gnetscher/RBG-Bike-POV/Spoke Ink/Poster.JPG

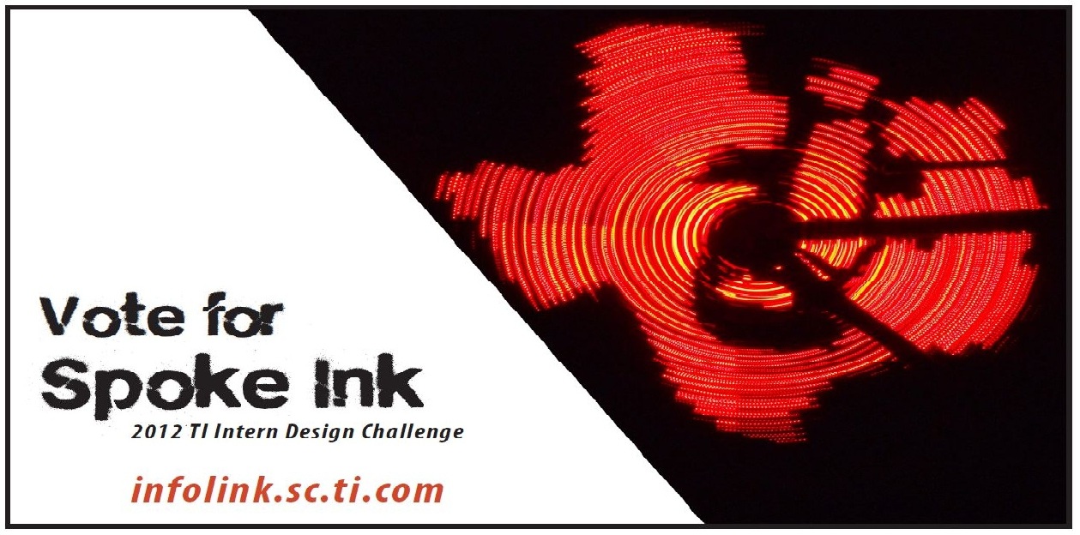
Spoke Ink/Poster.JPG
