gnetscher/RBG-Bike-POV/1st place.JPG

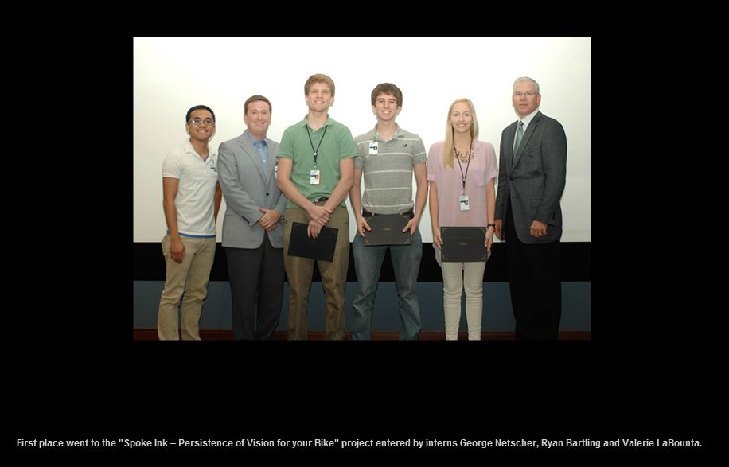
1st place.JPG
