gnetscher/RBG-Bike-POV/README.md

RBG-Bike-POV
============

Created for the TI Intern Design Contest 2012
