gnetscher/RBG-Bike-POV/Spoke Ink/Spoke_Ink_Mini_Flyer_2up_v4_bw1.pdf

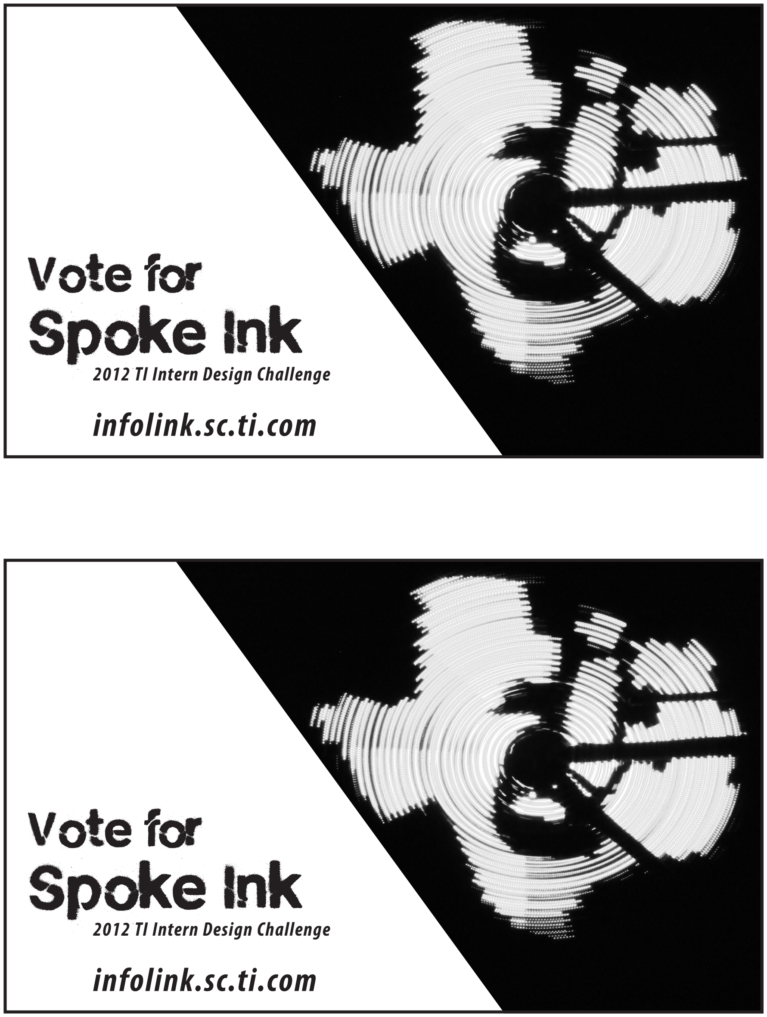
[picture p3: page 1]

Vote for Spoke Ink 2012 TI Intern Design Challenge

# infolink.sc.ti.com

Vote for Spoke Ink 2012 TI Intern Design Challenge

# infolink.sc.ti.com
