gnetscher/RBG-Bike-POV/Spoke Ink/Bike Pictures/142.JPG

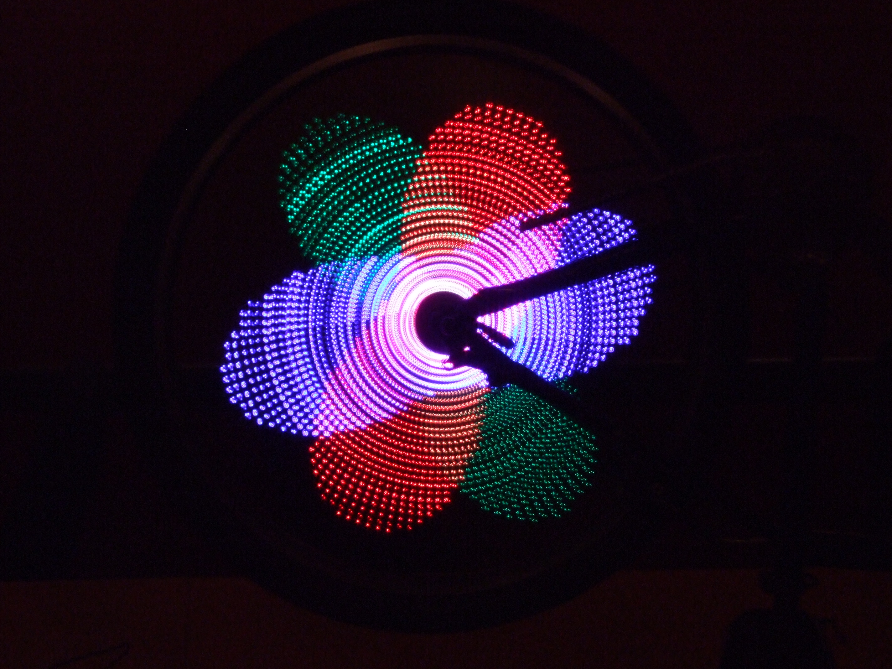
Spoke Ink/Bike Pictures/142.JPG
