gnetscher/RBG-Bike-POV/Spoke Ink/Bike Pictures/149.JPG

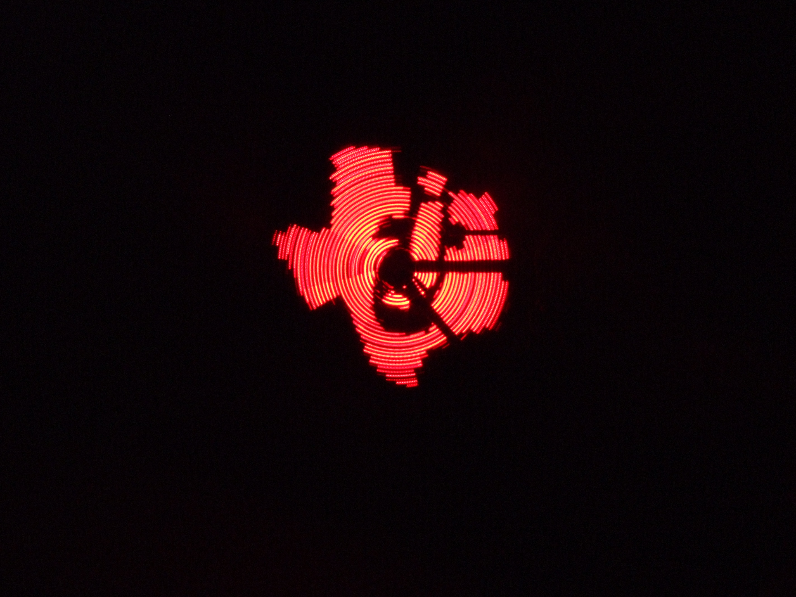
Spoke Ink/Bike Pictures/149.JPG
