gnetscher/RBG-Bike-POV/Spoke Ink/Bike Pictures/162.JPG

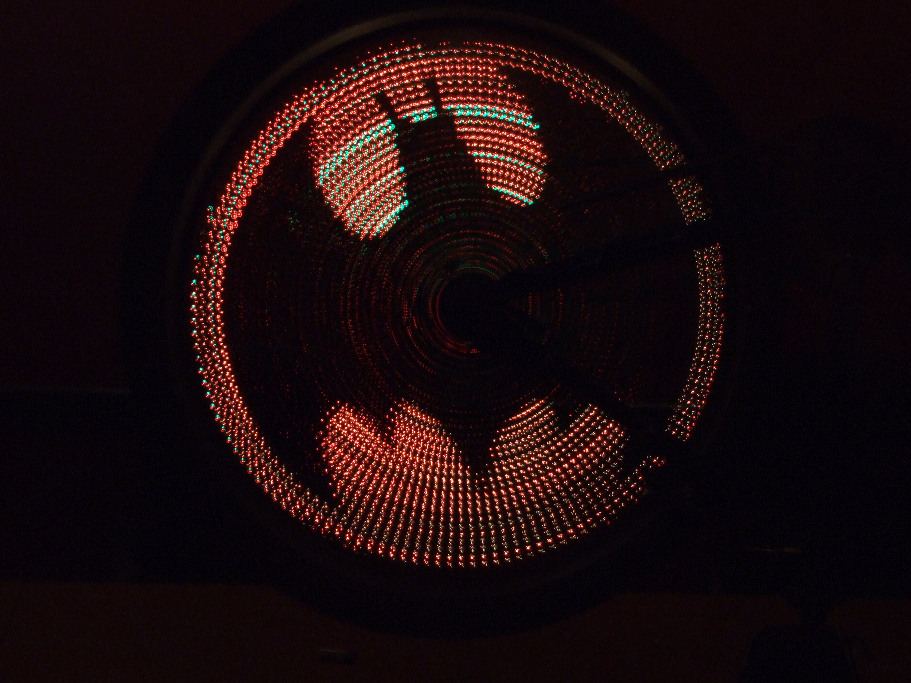
Spoke Ink/Bike Pictures/162.JPG
