gnetscher/RBG-Bike-POV/Spoke Ink/Bike Pictures/348.JPG

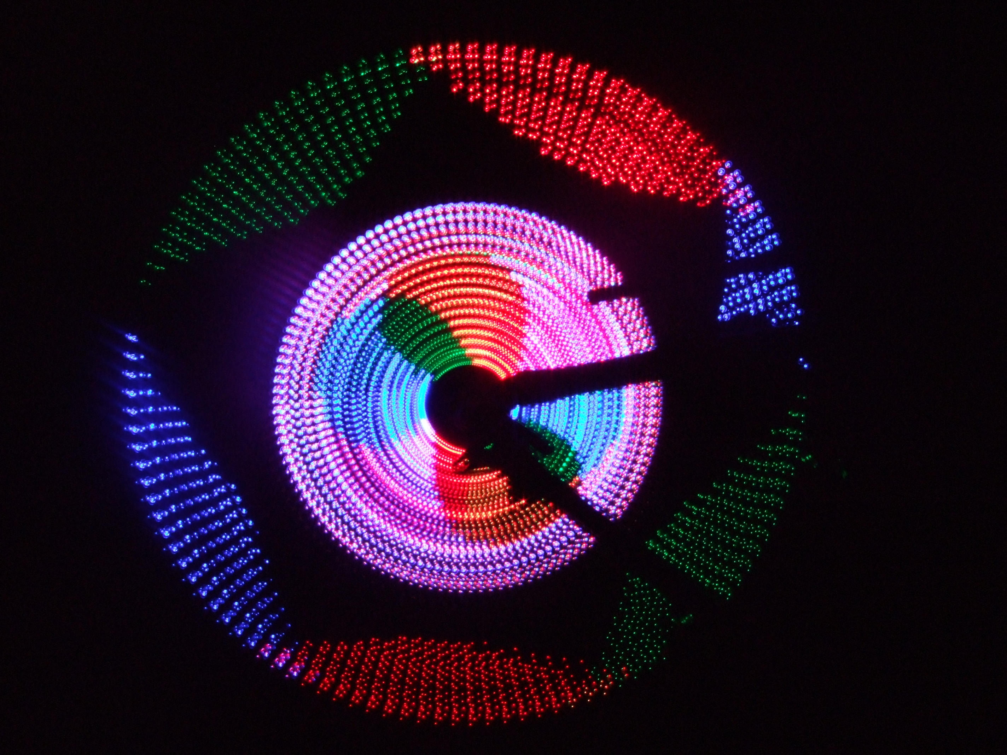
Spoke Ink/Bike Pictures/348.JPG
