gnetscher/RBG-Bike-POV/Spoke Ink/Bike Pictures/DSCF1652.JPG

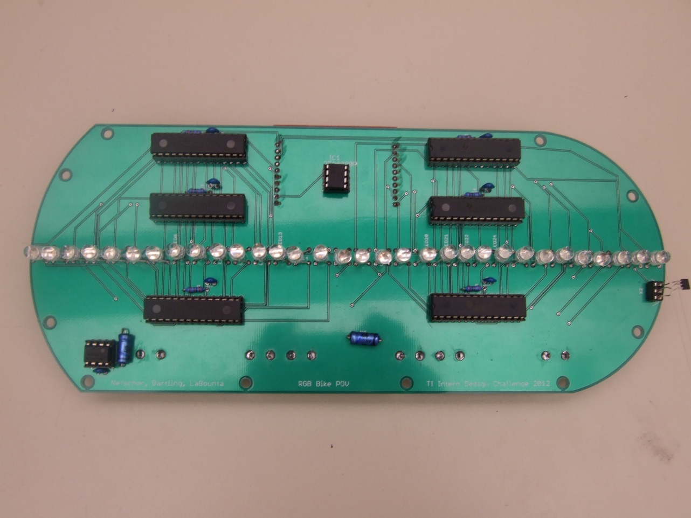
Spoke Ink/Bike Pictures/DSCF1652.JPG
