gnetscher/RBG-Bike-POV/Spoke Ink/Bike Pictures/DSCF1653.JPG

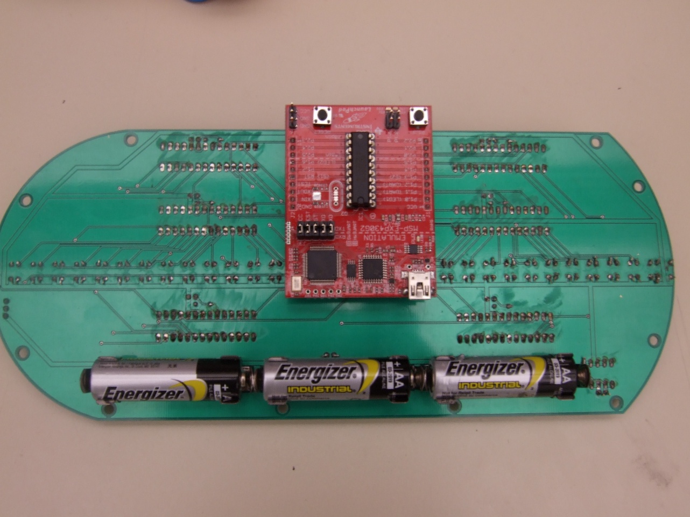
Spoke Ink/Bike Pictures/DSCF1653.JPG
