gnetscher/RBG-Bike-POV/Spoke Ink/Bike Pictures/Team.jpg

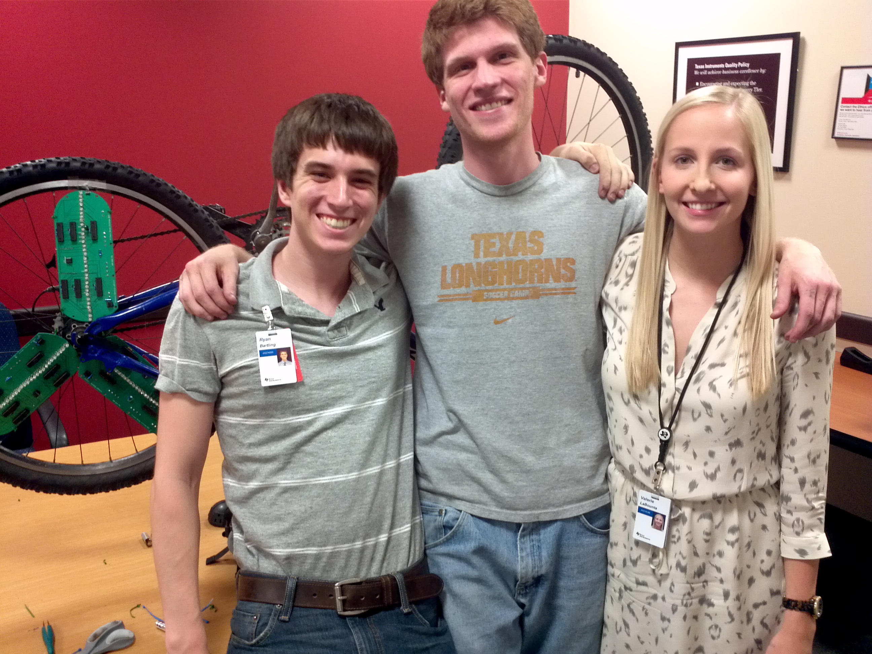
Spoke Ink/Bike Pictures/Team.jpg
