gnetscher/RBG-Bike-POV/Spoke Ink/Spoke Ink/Bill of Materials.docx

Spoke Ink – Bill of Materials

Part | Quantity | Price
Custom PCB | 3 | $260.68
Common Anode RGB LED | 96 | $57.70
US 5881 (Hall Effect Sensor) | 3 | $3.24
TLC5940 (LED driver) | 18 | $39.78
TPS7333 (Voltage Regulator) | 3 | $3.08
Battery Clips | 9 | $1.71

Total: $366.19

As compared to those offered commercially for $2000!

http://www.monkeylectric.com/video_pro_wheel_screen/
