gnetscher/RBG-Bike-POV/Spoke Ink/Spoke Ink/RGB_Bike_POV_v3.brd

## EAGLE design Spoke Ink/Spoke Ink/RGB_Bike_POV_v3.brd (2012-08-11)

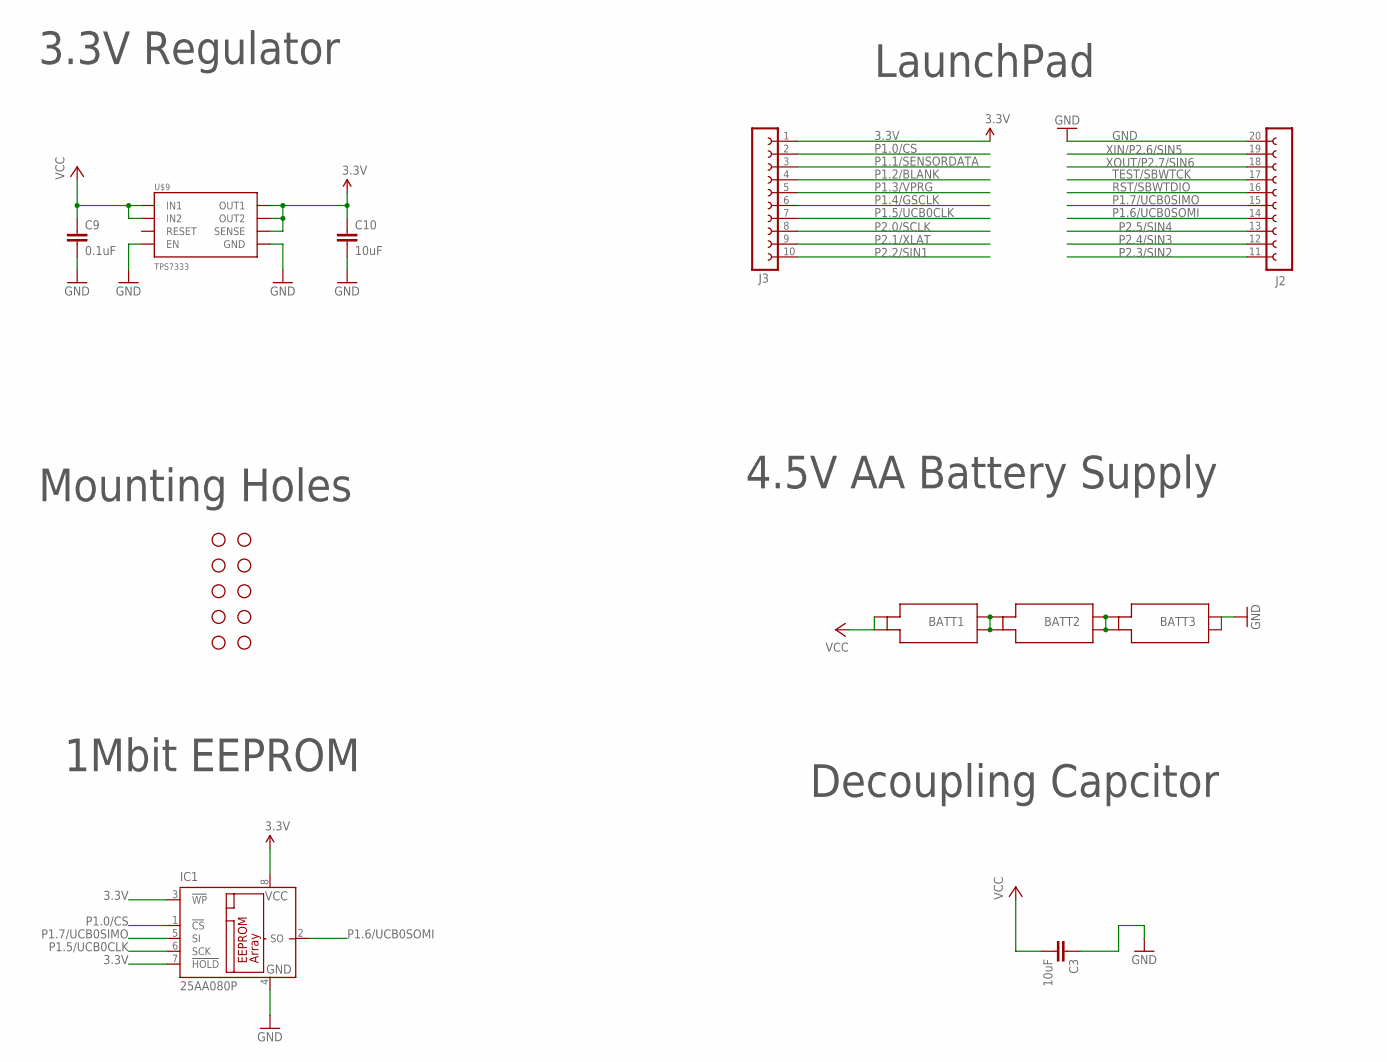
[picture p11: schematic RGB_Bike_POV_v3.sch, sheet 1]

Parts:
BATT1, BATT2, BATT3: 1XAA
C3, C10: 10uF; CAP-PTH-SMALL
C9: 0.1uF; CAP-PTH-SMALL
IC1: 25AA080P; DIL8
J2: FE10H
J3: FE10L; FE10
JP1, JP2, JP3, JP4, JP5, JP7, JP25, JP26, JP27, JP28: STAND-OFF
U$9: TPS7333

Connections:
3.3V: C10.1, IC1.3 (!WP), IC1.7 (!HOLD), IC1.8 (VCC), J3.1, U$9.5 (OUT1), U$9.6 (OUT2), U$9.7 (SENSE); also elsewhere on the board
GND: BATT3.N1, BATT3.N2, C3.1, C9.2, C10.2, IC1.4 (GND), J2.20 (10), U$9.1 (GND), U$9.2 (EN); also elsewhere on the board
unnamed: BATT1.N1, BATT1.N2, BATT2.P1, BATT2.P2
unnamed: BATT2.N1, BATT2.N2, BATT3.P1, BATT3.P2
P1.0/CS: IC1.1 (!CS), J3.2
P1.1/SENSORDATA: J3.3; also elsewhere on the board
P1.2/BLANK: J3.4; also elsewhere on the board
P1.3/VPRG: J3.5; also elsewhere on the board
P1.4/GSCLK: J3.6; also elsewhere on the board
P1.5/UCB0CLK: IC1.6 (SCK), J3.7
P1.6/UCB0SOMI: IC1.2 (SO), J2.14 (4)
P1.7/UCB0SIMO: IC1.5 (SI), J2.15 (5)
P2.0/SCLK: J3.8; also elsewhere on the board
P2.1/XLAT: J3.9; also elsewhere on the board
P2.2/SIN1: J3.10; also elsewhere on the board
P2.3/SIN2: J2.11 (1); also elsewhere on the board
P2.4/SIN3: J2.12 (2); also elsewhere on the board
P2.5/SIN4: J2.13 (3); also elsewhere on the board
RST/SBWTDIO: J2.16 (6)
TEST/SBWTCK: J2.17 (7)
VCC: BATT1.P1, BATT1.P2, C3.2, C9.1, U$9.3 (IN1), U$9.4 (IN2); also elsewhere on the board
XIN/P2.6/SIN5: J2.19 (9); also elsewhere on the board
XOUT/P2.7/SIN6: J2.18 (8); also elsewhere on the board

Notes on the sheet:
Mounting Holes
3.3V Regulator
LaunchPad
4.5V AA Battery Supply
1Mbit EEPROM
Decoupling Capcitor

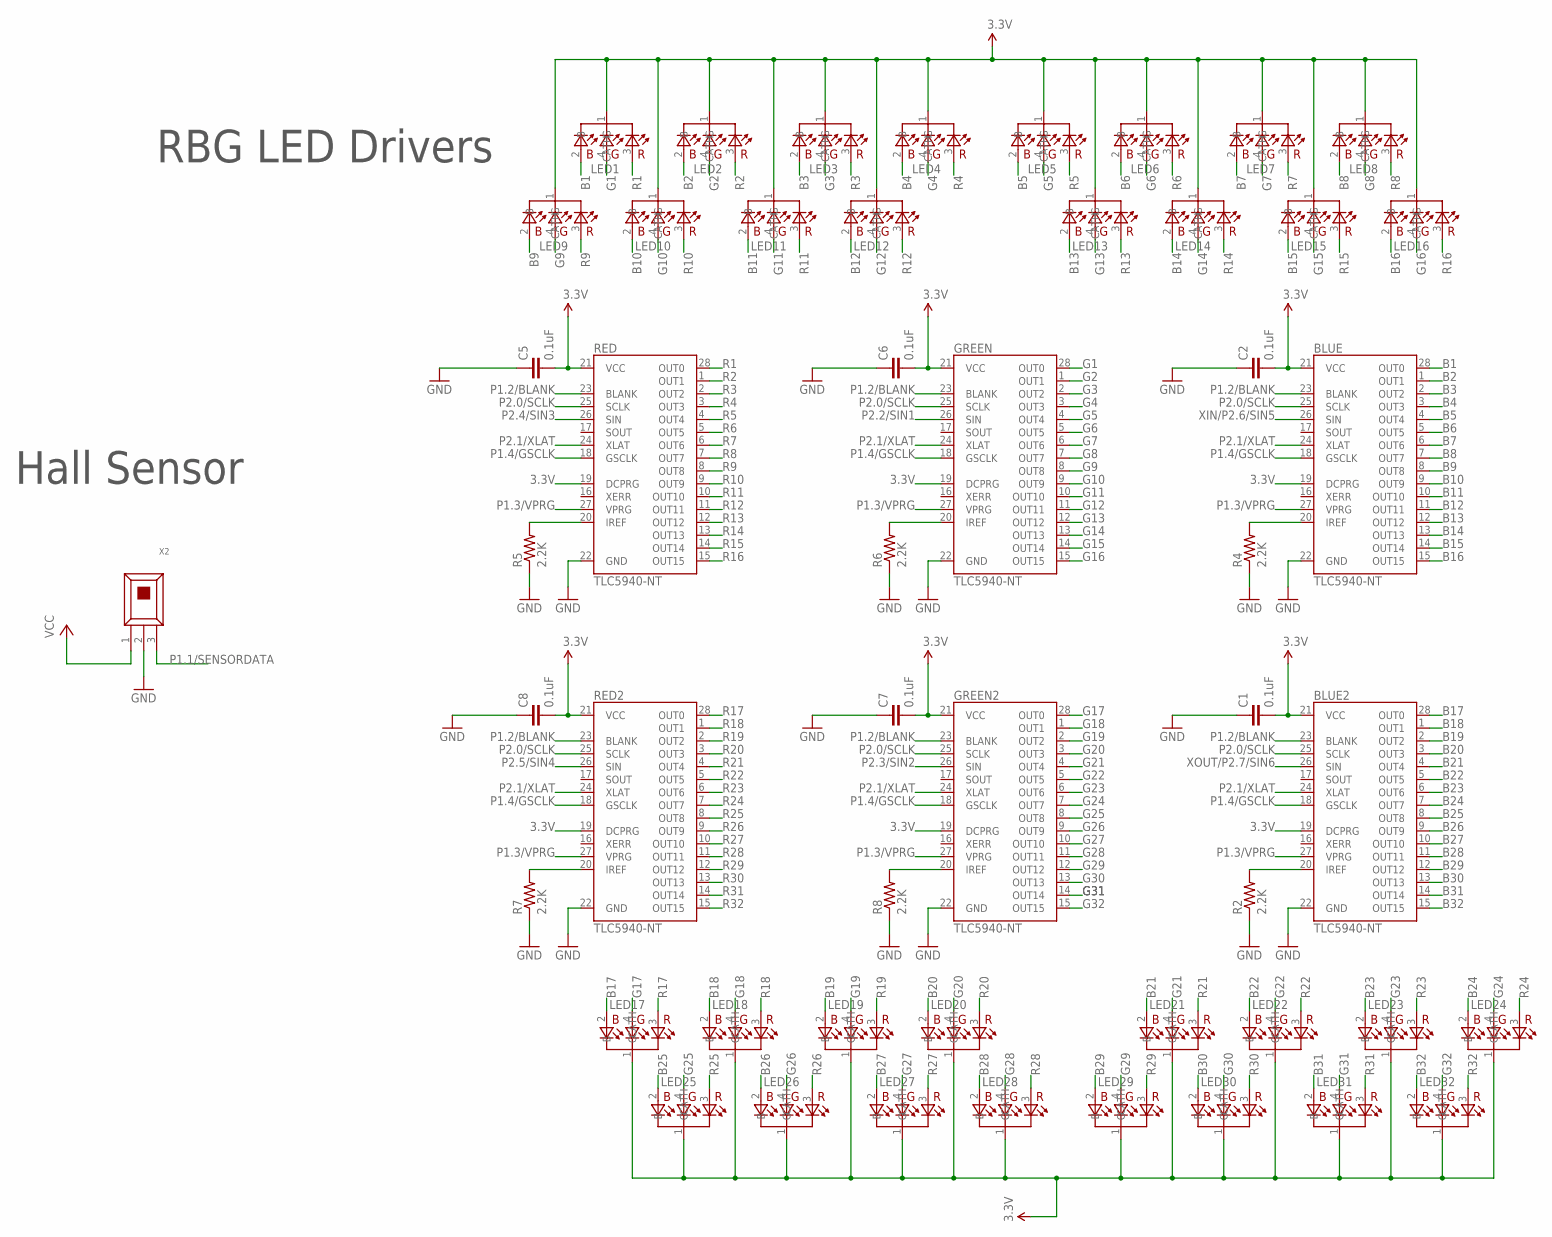
[picture p12: schematic RGB_Bike_POV_v3.sch, sheet 2]

Parts:
BLUE, BLUE2: TLC5940-NT; DIL28-3
C1, C2, C5, C6, C7, C8: 0.1uF; CAP-PTH-SMALL
GREEN, GREEN2: TLC5940-NT; DIL28-3
LED1, LED2, LED3, LED4, LED5, LED6, LED7, LED8, LED9, LED10, LED11, LED12, LED13, LED14, LED15, LED16, LED17, LED18, LED19, LED20, LED21, LED22, LED23, LED24, LED25, LED26, LED27, LED28, LED29, LED30, LED31, LED32: LED_SUPERFLUX_RGB_CATH; LED_SUPERFLUX
R2, R4, R5, R6, R7, R8: 2.2K; 1/6W-RES
RED, RED2: TLC5940-NT; DIL28-3
X2: HALLEFFECT; 3SIP

Connections:
3.3V: BLUE.19 (DCPRG), BLUE.21 (VCC), BLUE2.19 (DCPRG), BLUE2.21 (VCC), C1.2, C2.2, C5.2, C6.2, C7.2, C8.2, GREEN.19 (DCPRG), GREEN.21 (VCC), GREEN2.19 (DCPRG), GREEN2.21 (VCC), LED1.1 (CATH), LED2.1 (CATH), LED3.1 (CATH), LED4.1 (CATH), LED5.1 (CATH), LED6.1 (CATH), LED7.1 (CATH), LED8.1 (CATH), LED9.1 (CATH), LED10.1 (CATH), LED11.1 (CATH), LED12.1 (CATH), LED13.1 (CATH), LED14.1 (CATH), LED15.1 (CATH), LED16.1 (CATH), LED17.1 (CATH), LED18.1 (CATH), LED19.1 (CATH), LED20.1 (CATH), LED21.1 (CATH), LED22.1 (CATH), LED23.1 (CATH), LED24.1 (CATH), LED25.1 (CATH), LED26.1 (CATH), LED27.1 (CATH), LED28.1 (CATH), LED29.1 (CATH), LED30.1 (CATH), LED31.1 (CATH), LED32.1 (CATH), RED.19 (DCPRG), RED.21 (VCC), RED2.19 (DCPRG), RED2.21 (VCC); also elsewhere on the board
B1: BLUE.28 (OUT0), LED1.2 (B)
B2: BLUE.1 (OUT1), LED2.2 (B)
B3: BLUE.2 (OUT2), LED3.2 (B)
B4: BLUE.3 (OUT3), LED4.2 (B)
B5: BLUE.4 (OUT4), LED5.2 (B)
B6: BLUE.5 (OUT5), LED6.2 (B)
B7: BLUE.6 (OUT6), LED7.2 (B)
B8: BLUE.7 (OUT7), LED8.2 (B)
B9: BLUE.8 (OUT8), LED9.2 (B)
B10: BLUE.9 (OUT9), LED10.2 (B)
B11: BLUE.10 (OUT10), LED11.2 (B)
B12: BLUE.11 (OUT11), LED12.2 (B)
B13: BLUE.12 (OUT12), LED13.2 (B)
B14: BLUE.13 (OUT13), LED14.2 (B)
B15: BLUE.14 (OUT14), LED15.2 (B)
B16: BLUE.15 (OUT15), LED16.2 (B)
B17: BLUE2.28 (OUT0), LED17.2 (B)
B18: BLUE2.1 (OUT1), LED18.2 (B)
B19: BLUE2.2 (OUT2), LED19.2 (B)
B20: BLUE2.3 (OUT3), LED20.2 (B)
B21: BLUE2.4 (OUT4), LED21.2 (B)
B22: BLUE2.5 (OUT5), LED22.2 (B)
B23: BLUE2.6 (OUT6), LED23.2 (B)
B24: BLUE2.7 (OUT7), LED24.2 (B)
B25: BLUE2.8 (OUT8), LED25.2 (B)
B26: BLUE2.9 (OUT9), LED26.2 (B)
B27: BLUE2.10 (OUT10), LED27.2 (B)
B28: BLUE2.11 (OUT11), LED28.2 (B)
B29: BLUE2.12 (OUT12), LED29.2 (B)
B30: BLUE2.13 (OUT13), LED30.2 (B)
B31: BLUE2.14 (OUT14), LED31.2 (B)
B32: BLUE2.15 (OUT15), LED32.2 (B)
G1: GREEN.28 (OUT0), LED1.4 (G)
G2: GREEN.1 (OUT1), LED2.4 (G)
G3: GREEN.2 (OUT2), LED3.4 (G)
G4: GREEN.3 (OUT3), LED4.4 (G)
G5: GREEN.4 (OUT4), LED5.4 (G)
G6: GREEN.5 (OUT5), LED6.4 (G)
G7: GREEN.6 (OUT6), LED7.4 (G)
G8: GREEN.7 (OUT7), LED8.4 (G)
G9: GREEN.8 (OUT8), LED9.4 (G)
G10: GREEN.9 (OUT9), LED10.4 (G)
G11: GREEN.10 (OUT10), LED11.4 (G)
G12: GREEN.11 (OUT11), LED12.4 (G)
G13: GREEN.12 (OUT12), LED13.4 (G)
G14: GREEN.13 (OUT13), LED14.4 (G)
G15: GREEN.14 (OUT14), LED15.4 (G)
G16: GREEN.15 (OUT15), LED16.4 (G)
G17: GREEN2.28 (OUT0), LED17.4 (G)
G18: GREEN2.1 (OUT1), LED18.4 (G)
G19: GREEN2.2 (OUT2), LED19.4 (G)
G20: GREEN2.3 (OUT3), LED20.4 (G)
G21: GREEN2.4 (OUT4), LED21.4 (G)
G22: GREEN2.5 (OUT5), LED22.4 (G)
G23: GREEN2.6 (OUT6), LED23.4 (G)
G24: GREEN2.7 (OUT7), LED24.4 (G)
G25: GREEN2.8 (OUT8), LED25.4 (G)
G26: GREEN2.9 (OUT9), LED26.4 (G)
G27: GREEN2.10 (OUT10), LED27.4 (G)
G28: GREEN2.11 (OUT11), LED28.4 (G)
G29: GREEN2.12 (OUT12), LED29.4 (G)
G30: GREEN2.13 (OUT13), LED30.4 (G)
G31: GREEN2.14 (OUT14), LED31.4 (G)
G32: GREEN2.15 (OUT15), LED32.4 (G)
GND: BLUE.22 (GND), BLUE2.22 (GND), C1.1, C2.1, C5.1, C6.1, C7.1, C8.1, GREEN.22 (GND), GREEN2.22 (GND), R2.1, R4.1, R5.1, R6.1, R7.1, R8.1, RED.22 (GND), RED2.22 (GND), X2.2; also elsewhere on the board
unnamed: BLUE2.20 (IREF), R2.2
unnamed: BLUE.20 (IREF), R4.2
unnamed: R5.2, RED.20 (IREF)
unnamed: GREEN.20 (IREF), R6.2
unnamed: R7.2, RED2.20 (IREF)
unnamed: GREEN2.20 (IREF), R8.2
P1.1/SENSORDATA: X2.3; also elsewhere on the board
P1.2/BLANK: BLUE.23 (BLANK), BLUE2.23 (BLANK), GREEN.23 (BLANK), GREEN2.23 (BLANK), RED.23 (BLANK), RED2.23 (BLANK); also elsewhere on the board
P1.3/VPRG: BLUE.27 (VPRG), BLUE2.27 (VPRG), GREEN.27 (VPRG), GREEN2.27 (VPRG), RED.27 (VPRG), RED2.27 (VPRG); also elsewhere on the board
P1.4/GSCLK: BLUE.18 (GSCLK), BLUE2.18 (GSCLK), GREEN.18 (GSCLK), GREEN2.18 (GSCLK), RED.18 (GSCLK), RED2.18 (GSCLK); also elsewhere on the board
P2.0/SCLK: BLUE.25 (SCLK), BLUE2.25 (SCLK), GREEN.25 (SCLK), GREEN2.25 (SCLK), RED.25 (SCLK), RED2.25 (SCLK); also elsewhere on the board
P2.1/XLAT: BLUE.24 (XLAT), BLUE2.24 (XLAT), GREEN.24 (XLAT), GREEN2.24 (XLAT), RED.24 (XLAT), RED2.24 (XLAT); also elsewhere on the board
P2.2/SIN1: GREEN.26 (SIN); also elsewhere on the board
P2.3/SIN2: GREEN2.26 (SIN); also elsewhere on the board
P2.4/SIN3: RED.26 (SIN); also elsewhere on the board
P2.5/SIN4: RED2.26 (SIN); also elsewhere on the board
R1: LED1.3 (R), RED.28 (OUT0)
R2: LED2.3 (R), RED.1 (OUT1)
R3: LED3.3 (R), RED.2 (OUT2)
R4: LED4.3 (R), RED.3 (OUT3)
R5: LED5.3 (R), RED.4 (OUT4)
R6: LED6.3 (R), RED.5 (OUT5)
R7: LED7.3 (R), RED.6 (OUT6)
R8: LED8.3 (R), RED.7 (OUT7)
R9: LED9.3 (R), RED.8 (OUT8)
R10: LED10.3 (R), RED.9 (OUT9)
R11: LED11.3 (R), RED.10 (OUT10)
R12: LED12.3 (R), RED.11 (OUT11)
R13: LED13.3 (R), RED.12 (OUT12)
R14: LED14.3 (R), RED.13 (OUT13)
R15: LED15.3 (R), RED.14 (OUT14)
R16: LED16.3 (R), RED.15 (OUT15)
R17: LED17.3 (R), RED2.28 (OUT0)
R18: LED18.3 (R), RED2.1 (OUT1)
R19: LED19.3 (R), RED2.2 (OUT2)
R20: LED20.3 (R), RED2.3 (OUT3)
R21: LED21.3 (R), RED2.4 (OUT4)
R22: LED22.3 (R), RED2.5 (OUT5)
R23: LED23.3 (R), RED2.6 (OUT6)
R24: LED24.3 (R), RED2.7 (OUT7)
R25: LED25.3 (R), RED2.8 (OUT8)
R26: LED26.3 (R), RED2.9 (OUT9)
R27: LED27.3 (R), RED2.10 (OUT10)
R28: LED28.3 (R), RED2.11 (OUT11)
R29: LED29.3 (R), RED2.12 (OUT12)
R30: LED30.3 (R), RED2.13 (OUT13)
R31: LED31.3 (R), RED2.14 (OUT14)
R32: LED32.3 (R), RED2.15 (OUT15)
VCC: X2.1; also elsewhere on the board
XIN/P2.6/SIN5: BLUE.26 (SIN); also elsewhere on the board
XOUT/P2.7/SIN6: BLUE2.26 (SIN); also elsewhere on the board

Notes on the sheet:
RBG LED Drivers
Hall Sensor

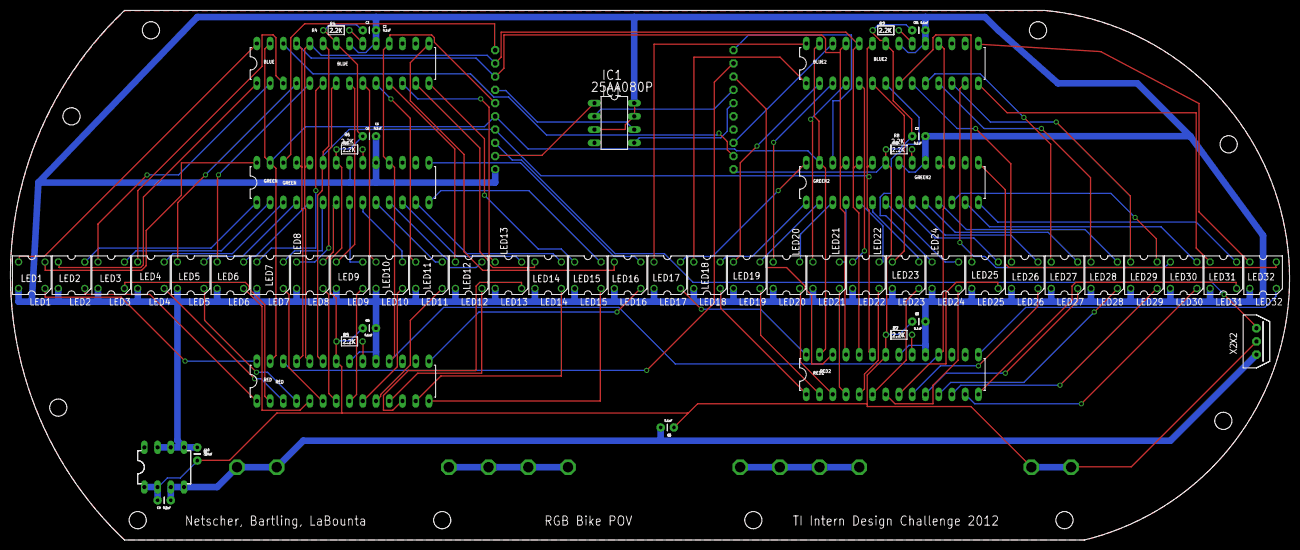
[picture p13: board RGB_Bike_POV_v3.brd from above]

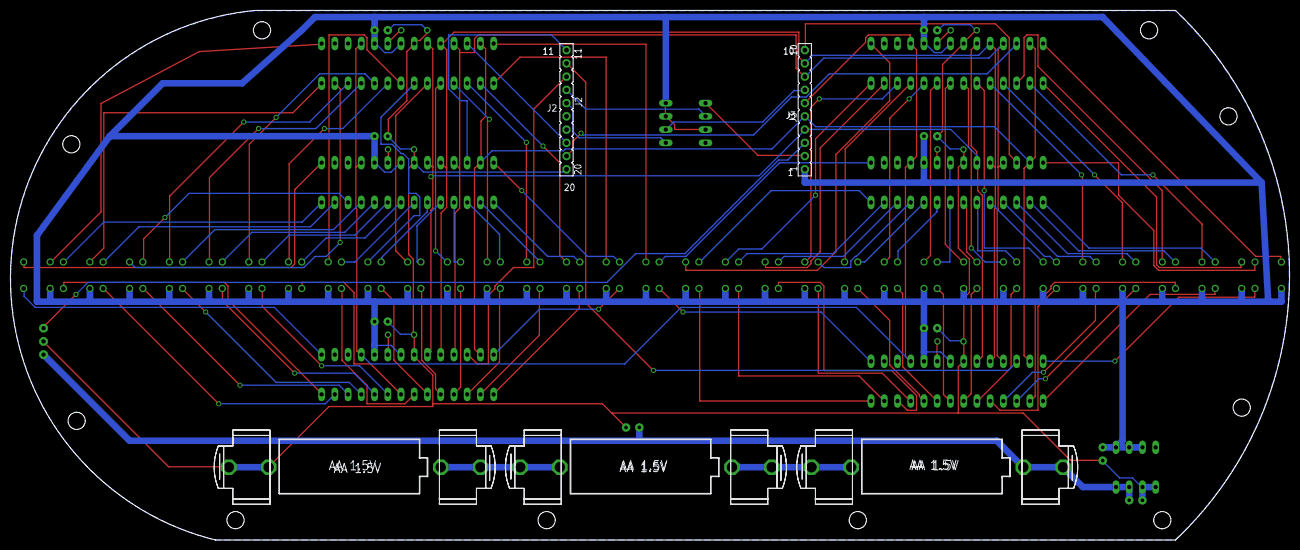
[picture p14: board RGB_Bike_POV_v3.brd from below]

Board: 2 copper layers, 245.4 x 101.6 mm, 71 parts (5 on the bottom side), 123 nets.
