gnetscher/RBG-Bike-POV/Spoke Ink/Spoke Ink/finalmainnostatemachine.c

//Great thanks to TI_RGB_TABLE for their code influence
//PIN1.0=CS
//PIN1.1=SENSORDATA
//PIN1.2=BLANK
//PIN1.3=VPRG
//PIN1.4=SMCLCK (GSCLCK)
//PIN1.5=UCB0CLK
//PIN1.6=UCB0SOMI
//PIN1.7=UCB0SIMO
//PIN2.0=SCLK
//PIN2.1=XLAT
//PIN2.2=SIN1
//PIN2.3=SIN2
//PIN2.4=SIN3
//PIN2.5=SIN4
//PIN2.6=SIN5
//PIN2.7=SIN6

#define XLAT BIT1
#define SIN1 BIT2
#define SIN2 BIT3
#define SIN3 BIT4
#define SIN4 BIT5
#define SIN5 BIT6
#define SIN6 BIT7
#define SCLK BIT0
#define BLANK BIT2
#define VPRG BIT3 //p1
#define GSCLK BIT4 //p2
#define NUM_LEDS (96)
unsigned int number_cycles;
volatile unsigned char need_xlat = 0;
unsigned char need_extra_sclk = 0;
const unsigned int wheel_divisions=128;	//number of lines that the image is composed
volatile int cycles=0;			//number of repetition of each line, will be controlled by sensor feedback
volatile unsigned int matrix_step=0;		//current matrix step
volatile unsigned int spins=0;			//for the feedback loop
volatile unsigned long VariableB=0;
volatile unsigned long Display_Interval=0;
volatile unsigned long VariableC=0;
volatile unsigned long VariableD=0;
volatile unsigned long Full_Rotation_Time;
volatile int matrixtest=1;
int i=0;
volatile int eq = 0;
unsigned char offset = 0;
volatile int flag;
#include  <msp430g2553.h>
#include "data.h"
#include "eeprom.h"
#include "HALL.h"

static const char green[128][16]={{0, 180, 201, 44, 44, 255, 255, 255, 255, 255, 254, 255, 255, 123, 230, 201}, {0, 180, 254, 69, 149, 255, 255, 255, 255, 255, 255, 255, 255, 254, 83, 255}, {0, 0, 254, 254, 255, 255, 255, 255, 255, 255, 255, 255, 255, 255, 254, 45}, {0, 0, 217, 254, 254, 255, 255, 255, 254, 149, 149, 255, 255, 255, 255, 135}, {0, 0, 217, 162, 255, 255, 254, 255, 43, 44, 44, 255, 255, 255, 255, 255}, {0, 0, 254, 70, 254, 255, 255, 255, 45, 45, 44, 149, 255, 255, 255, 254}, {0, 0, 254, 70, 254, 254, 254, 215, 44, 149, 43, 148, 255, 255, 255, 255}, {0, 0, 255, 176, 254, 254, 255, 216, 149, 254, 43, 44, 255, 255, 255, 255}, {0, 0, 255, 43, 255, 255, 255, 163, 255, 0, 148, 44, 255, 255, 255, 255}, {0, 0, 241, 44, 255, 255, 255, 254, 0, 0, 255, 44, 148, 255, 255, 255}, {0, 0, 241, 44, 255, 255, 254, 255, 0, 0, 154, 44, 44, 255, 255, 255}, {0, 0, 241, 44, 255, 255, 255, 255, 204, 0, 155, 148, 44, 255, 255, 255}, {0, 0, 241, 44, 255, 254, 255, 252, 255, 0, 0, 255, 44, 148, 255, 255}, {0, 0, 241, 44, 255, 255, 255, 255, 255, 0, 0, 155, 44, 44, 254, 254}, {0, 0, 121, 44, 255, 255, 255, 254, 255, 0, 0, 0, 255, 41, 149, 255}, {0, 0, 254, 44, 43, 255, 255, 255, 255, 0, 0, 0, 155, 148, 43, 255}, {0, 0, 254, 44, 43, 255, 255, 255, 255, 0, 0, 0, 0, 255, 44, 255}, {0, 0, 242, 44, 44, 255, 255, 255, 215, 0, 0, 0, 0, 0, 254, 255}, {0, 0, 255, 43, 44, 255, 255, 255, 149, 0, 0, 0, 0, 0, 255, 255}, {0, 0, 255, 43, 44, 44, 255, 254, 175, 0, 0, 0, 0, 255, 255, 254}, {0, 0, 104, 203,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
5, 255, 255, 255, 254, 255, 56, 255, 176}};


static const char green2[128][16]={{203, 254, 255, 255, 155, 155, 155, 155, 155, 155, 155, 155, 155, 0, 201, 255}, {44, 255, 255, 255, 0, 0, 0, 0, 0, 0, 0, 0, 0, 0, 255, 255}, {255, 45, 95, 255, 0, 0, 0, 0, 0, 0, 0, 0, 0, 0, 162, 255}, {121, 255, 45, 175, 0, 0, 0, 0, 0, 0, 0, 0, 0, 0, 255, 254}, {255, 108, 175, 255, 0, 0, 254, 255, 254, 0, 0, 0, 0, 0, 255, 255}, {255, 176, 45, 0, 0, 0, 67, 255, 255, 255, 242, 67, 0, 0, 175, 255}, {255, 255, 255, 242, 0, 0, 255, 104, 255, 0, 0, 0, 0, 0, 255, 255}, {255, 255, 255, 162, 0, 0, 0, 0, 79, 0, 0, 0, 0, 0, 242, 255}, {255, 255, 255, 254, 0, 0, 0, 0, 0, 0, 0, 0, 0, 0, 255, 255}, {255, 255, 255, 255, 0, 0, 0, 0, 0, 0, 0, 0, 0, 0, 242, 255}, {255, 255, 255, 255, 0, 0, 0, 0, 0, 0, 0, 0, 0, 0, 188, 255}, {255, 254, 255, 255, 0, 0, 0, 0, 0, 0, 0, 0, 0, 0, 241, 255}, {255, 255, 254, 255, 0, 0, 142, 68, 0, 0, 0, 0, 0, 0, 254, 255}, {255, 255, 255, 254, 0, 217, 229, 255, 230, 0, 154, 0, 0, 0, 255, 254}, {255, 255, 255, 255, 0, 167, 0, 0, 254, 255, 255, 0, 0, 0, 254, 254}, {254, 255, 255, 254, 0, 0, 254, 0, 0, 79, 0, 0, 0, 0, 176, 255}, {254, 254, 255, 255, 0, 0, 0, 0, 0, 0, 0, 0, 0, 0, 175, 255}, {255, 255, 255, 255, 0, 0, 0, 0, 0, 0, 0, 0, 0, 0, 254, 255}, {255, 255, 255, 255, 0, 0, 0, 0, 0, 0, 0, 0, 0, 0, 254, 255}, {255, 255, 255, 255, 0, 0, 0, 0, 0, 0, 0, 0, 0, 0, 255, 255}, {255, 255, 255, 255, 0, 130, 0, 0, 0, 0, 0, 0, 0, 0, 255, 254}, {255, 255, 255, 255, 0, 229, 255, 254, 217, 0, 0, 0, 0, 0, 201, 255}, {255, 255, 255, 242, 0, 0, 0, 254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
1, 1, 1, 1, 1, 3, 3, 1, 1, 1, 3, 1, 0}, {0, 3, 1, 1, 1, 1, 1, 3, 1, 1, 0, 3, 0, 1, 1, 23}, {0, 3, 1, 1, 1, 1, 1, 3, 3, 1, 1, 3, 1, 3, 3, 0}, {1, 0, 1, 1, 3, 3, 1, 3, 1, 1, 1, 1, 1, 3, 4, 7}, {1, 0, 1, 1, 3, 1, 1, 1, 1, 0, 1, 1, 1, 1, 1, 0}, {1, 0, 1, 1, 3, 1, 1, 3, 3, 0, 1, 1, 3, 1, 1, 0}, {1, 1, 1, 1, 3, 3, 1, 1, 1, 3, 1, 1, 1, 1, 1, 1}, {1, 1, 1, 1, 1, 3, 1, 1, 1, 0, 1, 1, 1, 1, 3, 3}, {1, 1, 1, 1, 1, 3, 1, 1, 1, 1, 1, 1, 0, 1, 1, 1}, {1, 1, 1, 1, 3, 3, 3, 1, 1, 1, 1, 0, 3, 1, 1, 1}, {1, 1, 1, 1, 3, 0, 3, 0, 1, 1, 1, 0, 1, 1, 1, 1}, {1, 1, 1, 1, 0, 0, 1, 0, 0, 0, 1, 0, 1, 1, 3, 1}, {1, 1, 1, 1, 0, 3, 3, 0, 0, 0, 1, 3, 3, 3, 1, 1}, {1, 1, 3, 1, 0, 1, 0, 1, 0, 0, 0, 1, 1, 1, 1, 1}, {1, 1, 3, 3, 1, 1, 0, 1, 1, 1, 0, 0, 0, 1, 1, 1}, {1, 1, 3, 3, 1, 3, 1, 1, 1, 1, 1, 1, 1, 1, 1, 0}, {1, 1, 3, 3, 1, 3, 1, 1, 1, 1, 1, 3, 1, 1, 1, 1}};

static const char blue2[128][16]={{1, 0, 0, 1, 1, 0, 1, 1, 0, 1, 0, 151, 148, 148, 0, 0}, {1, 1, 0, 0, 0, 1, 0, 0, 0, 0, 0, 148, 148, 146, 74, 0}, {0, 1, 1, 0, 0, 0, 0, 3, 0, 1, 0, 157, 149, 149, 23, 0}, {0, 1, 1, 0, 0, 1, 1, 1, 0, 1, 0, 147, 148, 148, 34, 0}, {0, 0, 1, 0, 1, 0, 1, 1, 1, 0, 0, 151, 147, 148, 65, 0}, {1, 1, 1, 0, 0, 1, 1, 0, 0, 0, 0, 151, 146, 147, 66, 0}, {1, 1, 1, 1, 0, 1, 1, 0, 0, 0, 0, 152, 146, 152, 0, 0}, {1, 1, 0, 1, 1, 0, 1, 1, 1, 1, 0, 158, 149, 147, 35, 0}, {1, 1, 1, 1, 0, 1, 0, 0, 1, 1, 0, 149, 150, 153, 0, 0}, {0, 3, 0, 0, 1, 0, 0, 1, 0, 0, 1, 153, 150, 151, 0, 0}, {0, 0, 1, 1, 0, 1, 1, 1, 1, 0, 0, 153, 151, 152, 0, 0}, {1, 1, 1, 1, 1, 1, 0, 1, 1, 0, 7, 153, 154, 159, 41, 0}, {1, 0, 0, 0, 1, 0, 1, 1, 0, 0, 0, 151, 152, 154, 0, 0}, {0, 1, 0, 1, 1, 1, 1, 1, 1, 1, 0, 162, 154, 152, 4, 0}, {0, 0, 0, 1, 0, 0, 1, 1, 1, 0, 19, 150, 152, 161, 0, 0}, {0, 3, 1, 1, 1, 0, 3, 0, 0, 1, 46, 153, 151, 163, 0, 0}, {165, 71, 0, 1, 1, 1, 0, 1, 0, 0, 0, 162, 153, 158, 0, 0}, {155, 155, 163, 6, 1, 1, 1, 1, 1, 1, 0, 154, 155, 155, 0, 0}, {152, 154, 153, 151, 159, 0, 1, 1, 1, 1, 4, 163, 154, 166, 0, 0}, {155, 153, 157, 154, 154, 165, 79, 3, 1, 1, 0, 166, 157, 119, 0, 0}, {154, 154, 155, 155, 155, 154, 153, 135, 0, 3, 0, 162, 154, 113, 0, 0}, {154, 154, 155, 152, 155, 155, 155, 153, 133, 1, 0, 158, 152, 133, 0, 0}, {154, 153, 153, 154, 154, 155, 154, 154, 154, 159, 1, 158, 155, 131, 0, 0}, {155, 155, 154, 157, 154, 154, 154, 154, 154, 151, 157, 154, 159, 109, 0, 0}, {155,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
 255, 255, 255, 255, 255}, {255, 255, 255, 255, 249, 0, 0, 0, 255, 255, 255, 255, 255, 255, 255, 255}};

static const char red2[128][16]={{255, 255, 255, 255, 255, 255, 255, 255, 255, 4, 0, 0, 0, 0, 0, 0}, {255, 255, 255, 255, 255, 255, 255, 255, 255, 6, 0, 0, 0, 0, 0, 0}, {255, 255, 255, 255, 255, 255, 238, 255, 255, 11, 3, 0, 0, 0, 0, 0}, {255, 255, 255, 255, 255, 255, 255, 255, 53, 7, 3, 0, 0, 0, 0, 0}, {255, 255, 255, 255, 255, 255, 255, 251, 6, 0, 0, 0, 0, 0, 0, 0}, {255, 255, 255, 255, 255, 255, 255, 0, 20, 0, 0, 0, 0, 0, 0, 0}, {255, 255, 255, 255, 255, 255, 255, 19, 1, 1, 0, 0, 0, 0, 0, 0}, {255, 255, 255, 255, 255, 255, 255, 15, 0, 0, 0, 0, 0, 0, 0, 0}, {251, 255, 255, 255, 255, 255, 247, 254, 1, 0, 0, 0, 0, 0, 0, 0}, {247, 255, 255, 255, 255, 255, 255, 255, 4, 0, 0, 0, 0, 0, 0, 0}, {255, 255, 255, 255, 255, 255, 255, 255, 255, 0, 0, 0, 0, 0, 0, 0}, {0, 238, 255, 255, 255, 255, 255, 255, 255, 255, 0, 0, 0, 0, 0, 0}, {9, 255, 255, 255, 255, 255, 255, 254, 251, 255, 0, 0, 0, 0, 0, 0}, {254, 252, 255, 255, 255, 255, 251, 255, 252, 3, 0, 0, 0, 0, 0, 0}, {251, 255, 255, 255, 255, 254, 254, 250, 0, 0, 0, 0, 0, 0, 0, 0}, {254, 255, 255, 255, 255, 255, 196, 0, 0, 0, 0, 0, 0, 0, 0, 0}, {247, 255, 251, 255, 254, 252, 3, 0, 0, 0, 0, 0, 0, 0, 0, 0}, {91, 243, 238, 250, 252, 0, 0, 0, 0, 0, 0, 0, 0, 0, 0, 0}, {0, 0, 127, 252, 0, 0, 1, 0, 0, 0, 0, 0, 0, 0, 0, 0}, {0, 0, 0, 0, 0, 1, 0, 0, 0, 0, 0, 0, 0, 0, 0, 0}, {0, 0, 0, 15, 0, 0, 0, 0, 0, 0, 0, 0, 0, 0, 0, 0}, {0, 0, 104, 79, 23, 0, 0, 0, 0, 0, 0, 0, 0, 0, 0, 0}, {0, 255, 252, 241, 255, 58, 0, 0, 0, 0, 0, 0, 0, 0, 0, 0}, {27, 255, 2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
, 255, 255, 255, 255, 255, 251, 0, 0, 0, 0, 0, 0, 0}, {255, 255, 255, 255, 255, 255, 255, 251, 254, 150, 0, 0, 0, 0, 0, 0}, {255, 255, 255, 255, 255, 255, 255, 255, 255, 249, 0, 0, 0, 0, 0, 0}, {255, 255, 255, 255, 255, 255, 255, 255, 255, 251, 200, 3, 0, 0, 0, 0}, {255, 255, 255, 255, 255, 255, 255, 255, 255, 255, 247, 0, 0, 0, 0, 0}, {255, 255, 255, 255, 255, 255, 255, 255, 249, 255, 255, 11, 0, 0, 0, 0}, {255, 255, 255, 255, 255, 255, 238, 95, 0, 0, 0, 0, 0, 0, 0, 0}, {255, 255, 255, 255, 244, 1, 1, 1, 0, 0, 0, 0, 0, 0, 0, 0}, {255, 255, 244, 184, 13, 1, 0, 0, 0, 0, 0, 0, 0, 0, 0, 0}, {251, 244, 255, 3, 0, 0, 0, 0, 0, 0, 0, 0, 0, 0, 0, 0}, {255, 255, 170, 0, 0, 0, 0, 0, 0, 0, 0, 0, 0, 0, 0, 0}, {255, 255, 0, 0, 0, 0, 0, 0, 0, 0, 0, 0, 0, 0, 0, 0}, {255, 250, 0, 9, 0, 0, 0, 0, 0, 0, 0, 0, 0, 0, 0, 0}, {250, 249, 0, 0, 0, 0, 0, 0, 0, 0, 0, 0, 0, 0, 0, 0}, {255, 251, 7, 0, 0, 0, 0, 0, 0, 0, 0, 0, 0, 0, 0, 0}, {255, 255, 0, 6, 0, 0, 0, 0, 0, 0, 0, 0, 0, 0, 0, 0}, {255, 255, 0, 0, 0, 0, 0, 0, 0, 0, 0, 0, 0, 0, 0, 0}, {255, 251, 171, 0, 0, 0, 0, 0, 0, 0, 0, 0, 0, 0, 0, 0}, {254, 246, 246, 0, 0, 0, 0, 0, 0, 0, 0, 0, 0, 0, 0, 0}, {255, 255, 255, 26, 0, 6, 0, 0, 0, 0, 0, 0, 0, 0, 0, 0}, {255, 255, 255, 255, 0, 6, 0, 0, 0, 0, 0, 0, 0, 0, 0, 0}, {255, 255, 255, 252, 255, 13, 0, 0, 0, 0, 0, 0, 0, 0, 0, 0}, {255, 255, 255, 252, 243, 255, 3, 3, 0, 0, 0, 0, 0, 0, 0, 0}, {255, 255, 255, 255, 255, 255, 255, 7, 4, 0, 0, 0, 0, 0, 0, 0}, {255, 255, 255, 255, 255, 255, 255, 244, 234, 0, 0, 0, 0, 0, 0, 0}, {255, 255, 255, 255, 255, 255, 255, 247, 255, 0, 0, 0, 0, 0, 0, 0}, {255, 255, 255, 255, 255, 255, 255, 255, 255, 0, 0, 0, 0, 0, 0, 0}, {255, 255, 255, 255, 255, 255, 255, 255, 255, 9, 0, 0, 0, 0, 0, 0}, {255, 255, 255, 255, 255, 255, 255, 255, 255, 0, 3, 0, 0, 0, 0, 0}, {255, 255, 255, 255, 255, 255, 255, 255, 251, 3, 3, 0, 0, 0, 0, 0}};

static inline void init_dc()
{
    // enter DC data input mode
    P1OUT |= VPRG;

    // set everything to 0xFF
    P2OUT |= SIN1;
    P2OUT |= SIN2;
    P2OUT |= SIN3;
    P2OUT |= SIN4;
    P2OUT |= SIN5;
    P2OUT |= SIN6;

    // DC register is 96 bits, we have 6 chips
    for (i=0; i<(96); i++)
    {
        P2OUT |= SCLK;
        P2OUT &= ~SCLK;
    }

    P2OUT &= ~SIN1;
    P2OUT &= ~SIN2;
    P2OUT &= ~SIN3;
    P2OUT &= ~SIN4;
    P2OUT &= ~SIN5;
    P2OUT &= ~SIN6;

    // latch in the data
    P2OUT |= XLAT;
    P2OUT &= ~XLAT;
    P2OUT |= SCLK;
    P2OUT &= ~SCLK;
    // switch back to GS mode
    P1OUT &= ~VPRG;

    need_extra_sclk = 1;
}

static inline void refresh_leds()
{
    // if were waiting for a latch dont update again
    if (need_xlat == 0)
    {
    	for (i=15; i>-1; i--)
    	{
    		unsigned char radius = (i+offset)/*%16*/;
            // 4 pad bits
            P2OUT &= ~SIN1;
            P2OUT &= ~SIN2;
            P2OUT &= ~SIN3;
            P2OUT &= ~SIN4;
            P2OUT &= ~SIN5;
            P2OUT &= ~SIN6;

            P2OUT |= SCLK;
            P2OUT &= ~SCLK;

            P2OUT |= SCLK;
            P2OUT &= ~SCLK;

            P2OUT |= SCLK;
            P2OUT &= ~SCLK;

            P2OUT |= SCLK;
            P2OUT &= ~SCLK;

            // 8 data bits
            if (green[matrix_step][radius] & (1 << 7)) { P2OUT |= SIN1; } else { P2OUT &= ~SIN1; }
            if (green2[matrix_step][radius] & (1 << 7)) { P2OUT |= SIN2; } else { P2OUT &= ~SIN2; }
            if (red[matrix_step][radius] & (1 << 7)) { P2OUT |= SIN3; } else { P2OUT &= ~SIN3; }
            if (red2[matrix_step][radius] & (1 << 7)) { P2OUT |= SIN4; } else { P2OUT &= ~SIN4; }
            if (blue[matrix_step][radius] & (1 << 7)) { P2OUT |= SIN5; } else { P2OUT &= ~SIN5; }
            if (blue2[matrix_step][radius] & (1 << 7)) { P2OUT |= SIN6; } else { P2OUT &= ~SIN6; }

            P2OUT |= SCLK;
            P2OUT &= ~SCLK;

            if (green[matrix_step][radius] & (1 << 6)) { P2OUT |= SIN1; } else { P2OUT &= ~SIN1; }
            if (green2[matrix_step][radius] & (1 << 6)) { P2OUT |= SIN2; } else { P2OUT &= ~SIN2; }
            if (red[matrix_step][radius] & (1 << 6)) { P2OUT |= SIN3; } else { P2OUT &= ~SIN3; }
            if (red2[matrix_step][radius] & (1 << 6)) { P2OUT |= SIN4; } else { P2OUT &= ~SIN4; }
            if (blue[matrix_step][radius] & (1 << 6)) { P2OUT |= SIN5; } else { P2OUT &= ~SIN5; }
            if (blue2[matrix_step][radius] & (1 << 6)) { P2OUT |= SIN6; } else { P2OUT &= ~SIN6; }

            P2OUT |= SCLK;
            P2OUT &= ~SCLK;

           if (green[matrix_step][radius] & (1 << 5)) { P2OUT |= SIN1; } else { P2OUT &= ~SIN1; }
            if (green2[matrix_step][radius] & (1 << 5)) { P2OUT |= SIN2; } else { P2OUT &= ~SIN2; }
           if (red[matrix_step][radius] & (1 << 5)) { P2OUT |= SIN3; } else { P2OUT &= ~SIN3; }
            if (red2[matrix_step][radius] & (1 << 5)) { P2OUT |= SIN4; } else { P2OUT &= ~SIN4; }
            if (blue[matrix_step][radius] & (1 << 5)) { P2OUT |= SIN5; } else { P2OUT &= ~SIN5; }
            if (blue2[matrix_step][radius] & (1 << 5)) { P2OUT |= SIN6; } else { P2OUT &= ~SIN6; }

            P2OUT |= SCLK;
            P2OUT &= ~SCLK;

          if (green[matrix_step][radius] & (1 << 4)) { P2OUT |= SIN1; } else { P2OUT &= ~SIN1; }
            if (green2[matrix_step][radius] & (1 << 4)) { P2OUT |= SIN2; } else { P2OUT &= ~SIN2; }
            if (red[matrix_step][radius] & (1 << 4)) { P2OUT |= SIN3; } else { P2OUT &= ~SIN3; }
           if (red2[matrix_step][radius] & (1 << 4)) { P2OUT |= SIN4; } else { P2OUT &= ~SIN4; }
            if (blue[matrix_step][radius] & (1 << 4)) { P2OUT |= SIN5; } else { P2OUT &= ~SIN5; }
            if (blue2[matrix_step][radius] & (1 << 4)) { P2OUT |= SIN6; } else { P2OUT &= ~SIN6; }

            P2OUT |= SCLK;
            P2OUT &= ~SCLK;

            if (green[matrix_step][radius] & (1 << 3)) { P2OUT |= SIN1; } else { P2OUT &= ~SIN1; }
            if (green2[matrix_step][radius] & (1 << 3)) { P2OUT |= SIN2; } else { P2OUT &= ~SIN2; }
          if (red[matrix_step][radius] & (1 << 3)) { P2OUT |= SIN3; } else { P2OUT &= ~SIN3; }
           if (red2[matrix_step][radius] & (1 << 3)) { P2OUT |= SIN4; } else { P2OUT &= ~SIN4; }
            if (blue[matrix_step][radius] & (1 << 3)) { P2OUT |= SIN5; } else { P2OUT &= ~SIN5; }
            if (blue2[matrix_step][radius] & (1 << 3)) { P2OUT |= SIN6; } else { P2OUT &= ~SIN6; }

            P2OUT |= SCLK;
            P2OUT &= ~SCLK;

            if (green[matrix_step][radius] & (1 << 2)) { P2OUT |= SIN1; } else { P2OUT &= ~SIN1; }
            if (green2[matrix_step][radius] & (1 << 2)) { P2OUT |= SIN2; } else { P2OUT &= ~SIN2; }
           if (red[matrix_step][radius] & (1 << 2)) { P2OUT |= SIN3; } else { P2OUT &= ~SIN3; }
           if (red2[matrix_step][radius] & (1 << 2)) { P2OUT |= SIN4; } else { P2OUT &= ~SIN4; }
            if (blue[matrix_step][radius] & (1 << 2)) { P2OUT |= SIN5; } else { P2OUT &= ~SIN5; }
            if (blue2[matrix_step][radius] & (1 << 2)) { P2OUT |= SIN6; } else { P2OUT &= ~SIN6; }

            P2OUT |= SCLK;
            P2OUT &= ~SCLK;

            if (green[matrix_step][radius] & (1 << 1)) { P2OUT |= SIN1; } else { P2OUT &= ~SIN1; }
            if (green2[matrix_step][radius] & (1 << 1)) { P2OUT |= SIN2; } else { P2OUT &= ~SIN2; }
            if (red[matrix_step][radius] & (1 << 1)) { P2OUT |= SIN3; } else { P2OUT &= ~SIN3; }
            if (red2[matrix_step][radius] & (1 << 1)) { P2OUT |= SIN4; } else { P2OUT &= ~SIN4; }
            if (blue[matrix_step][radius] & (1 << 1)) { P2OUT |= SIN5; } else { P2OUT &= ~SIN5; }
            if (blue2[matrix_step][radius] & (1 << 1)) { P2OUT |= SIN6; } else { P2OUT &= ~SIN6; }

            P2OUT |= SCLK;
            P2OUT &= ~SCLK;

            if (green[matrix_step][radius] & (1 << 0)) { P2OUT |= SIN1; } else { P2OUT &= ~SIN1; }
            if (green2[matrix_step][radius] & (1 << 0)) { P2OUT |= SIN2; } else { P2OUT &= ~SIN2; }
            if (red[matrix_step][radius] & (1 << 0)) { P2OUT |= SIN3; } else { P2OUT &= ~SIN3; }
            if (red2[matrix_step][radius] & (1 << 0)) { P2OUT |= SIN4; } else { P2OUT &= ~SIN4; }
            if (blue[matrix_step][radius] & (1 << 0)) { P2OUT |= SIN5; } else { P2OUT &= ~SIN5; }
            if (blue2[matrix_step][radius] & (1 << 0)) { P2OUT |= SIN6; } else { P2OUT &= ~SIN6; }

            P2OUT |= SCLK;
            P2OUT &= ~SCLK;
    	}
        need_xlat = 1;

    }


}

int main(void)
{


	WDTCTL = WDTPW + WDTHOLD; // Stop WDT

    //
    // clock
    //

    BCSCTL1 = CALBC1_16MHZ;
    DCOCTL = CALDCO_16MHZ;

    P1DIR |= BIT5 | BIT6 | BIT7;

    //
    // SPI
    //
//    Init_SPI();
    Init_HALL();
    //
    // TLC5941
    //

    // all control lines are outputs
    P2DIR |= XLAT;
    P2DIR |= SIN1;
    P2DIR |= SIN2;
    P2DIR |= SIN3;
    P2DIR |= SIN4;
    P2DIR |= SIN5;
    P2DIR |= SIN6;
    P2DIR |= SCLK;
    P1DIR |= BLANK;
    P1DIR |= VPRG;
    P1DIR |= GSCLK;

    // GSCLK = SMCLK
    P1SEL |= GSCLK;
    P2SEL &= ~SIN5;
    P2SEL2 &= ~SIN5;
    P2SEL &= ~SIN6;
    P2SEL2 &= ~SIN6;

    // set all control lines to 0
    P2OUT &= ~XLAT;
    P2OUT &= ~SIN1;
    P2OUT &= ~SIN2;				//Remember to set correct pins some p1
    P2OUT &= ~SIN3;
    P2OUT &= ~SIN4;
    P2OUT &= ~SIN5;
    P2OUT &= ~SIN6;
    P2OUT &= ~SCLK;
    P1OUT &= ~BLANK;
    P1OUT &= ~VPRG;
    P1OUT &= ~GSCLK;

    // setup timers
    TA0CCTL0 = OUTMOD_3 | CCIE;
    TA0CCR0 = 512;
    TA0CTL = TASSEL_2 | MC_1; // SMCLK | Up mode

    init_dc();
    // enable interrupts
    _EINT();
    // initialize the table array

	while(1) {
		refresh_leds();
	}}
// Timer Vector
#pragma vector=TIMER0_A0_VECTOR
__interrupt void Timer_A (void)
{
//	_DINT();
	VariableB = VariableB + 1;
	VariableC = VariableC + 1;

	//_DINT();
    P1OUT |= BLANK;
    // check if we have new data that needs to be latched
    if (matrixtest)
    {
        // latch all the new data
        P2OUT |= XLAT;
        P2OUT &= ~XLAT;
        need_xlat = 0;

        if (need_extra_sclk)
        {
            P2OUT |= SCLK;
            P2OUT &= ~SCLK;
            need_extra_sclk = 0;
        }
        matrixtest = 0;
    }
    // enable the GS counter
    P1OUT &= ~BLANK;
    if ((VariableC == Display_Interval))
    	   {
    	    		matrix_step++;			//if so, next step
    	    		matrixtest = 1;
    	    		if(matrix_step == wheel_divisions)  {
    	    					matrix_step = 0;
    	    											}
    	        	VariableC = 0;

    	    }

}

//Hall Vector
#pragma vector=PORT1_VECTOR
__interrupt void Port_1(void)
{
//	_DINT();
//	Full_Rotation_Time = VariableB;
    Display_Interval = VariableB>>7;
	matrix_step = 0;
	VariableC = 0;
    VariableB = 0;
    //CHANGE HERE
//    TA1CTL |= TACLR;
//	VariableD = VariableD + 1;

	P1IFG &= ~BIT1;                           // P1.1 IFG cleared
//	offset += 3;  // used to animate pixels radially
//    _EINT();

}
